gunicsba/AgIsoAuxInputs/hardware/enclosures/handgrip/README.md

# Handgrip housing

A 3D-printed handheld grip for the [Handgrip keypad](../../boards/handgrip/). The layout is inspired by the HARDI NOVA sprayer grip; this project is not affiliated with HARDI.

Printed Handgrip housing with the keypad fitted

| File | Use |
|---|---|
| `handgrip_enclosure.3mf` | Ready to slice and print |
| `handgrip_enclosure.f3z` | Fusion 360 source archive |
