gunicsba/AgIsoAuxInputs/hardware/boards/handgrip/PCB_handgrip_2026-09-13.pdf

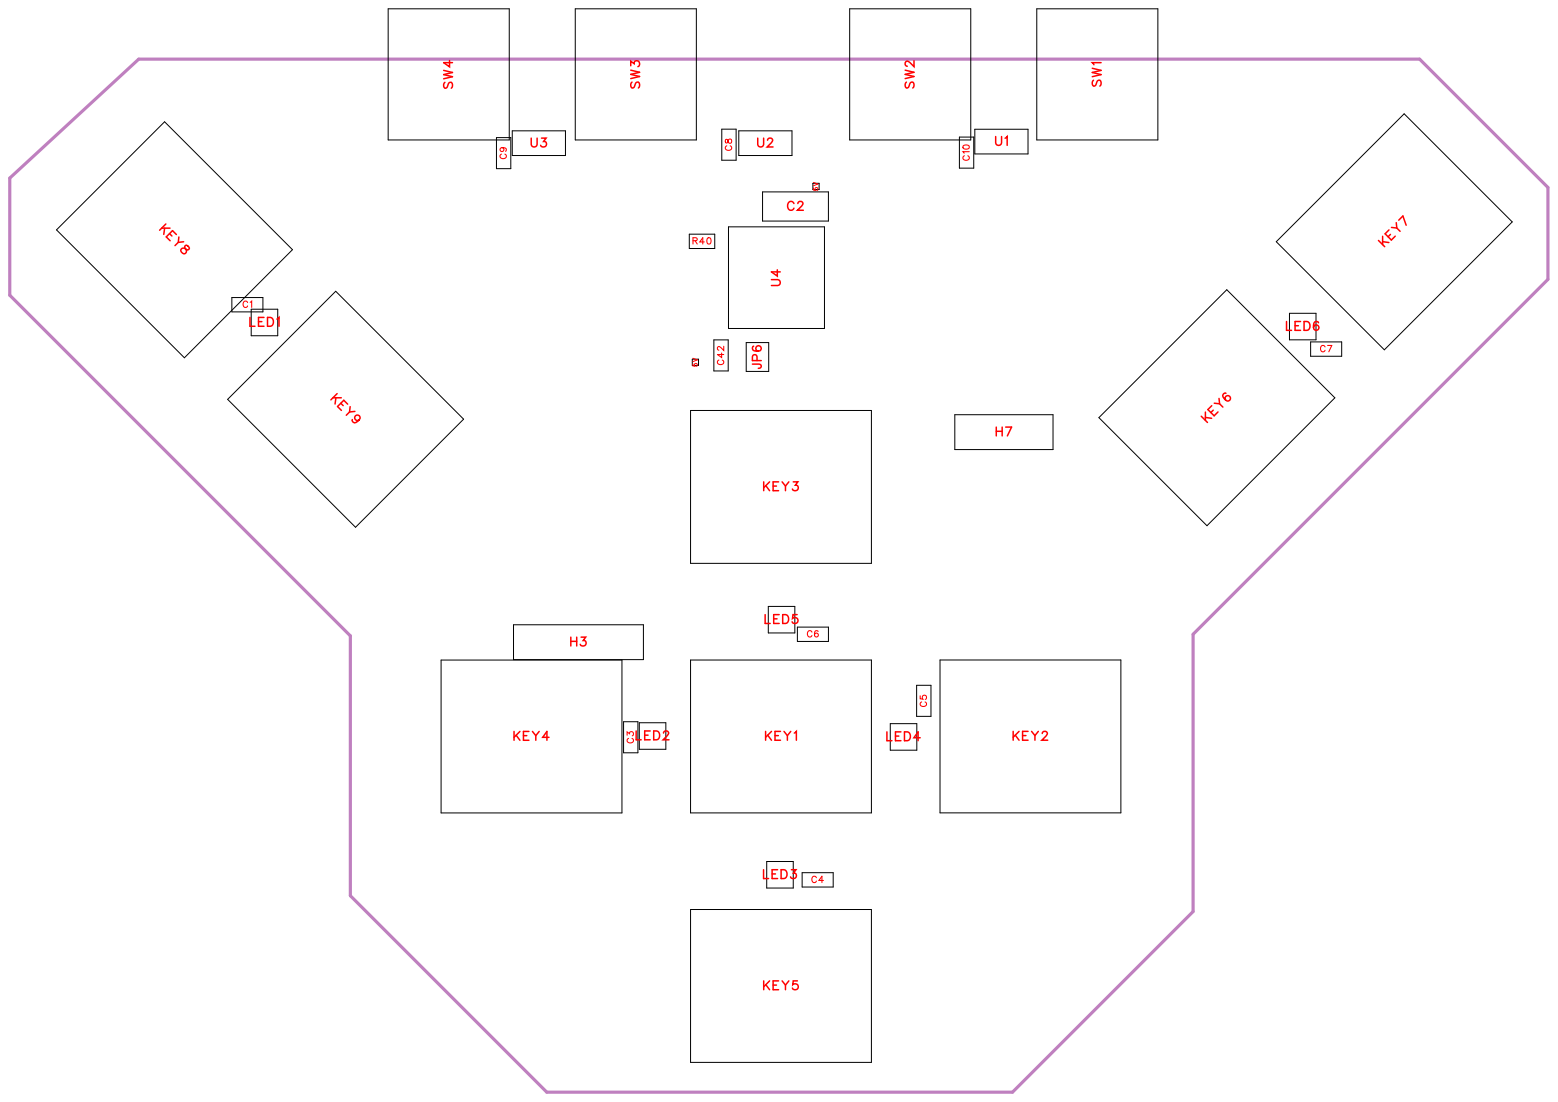
[picture p5: page 1]

H2

H1

No. | Quantity | Comment | Designator | Footprint | Value | Manufacturer Part | Manufacturer | Supplier Part | Supplier | Device | Name
1 | 2 | Test-Point | 5V,5V | Test-Point-0. 5mm | | | | | | Test-Point
2 | 10 | 100nF | C1,C3,C4,C5,C6,C7,C8,C9, C10,C42 | C0402 | 100nF | CL05B104K O5NNNC | SAMSUNG( ) 三星 | C1525 | LCSC | CL05B104K O5NNNC | 100nF
3 | 1 | 100uF | C2 | C1206 | 100uF | CL31A107M QHNNNE | SAMSUNG( 三星 ) | C15008 | LCSC | CL31A107M QHNNNE | 100uF
4 | 9 | B3F-4055 | KEY1,KEY2,KEY3,KEY4,K EY5,KEY6,KEY7,KEY8,KE Y9 | KEY-TH_4P-L12.0-W12.0-P5.00-LS13. 4-EH | | B3F-4055 | OMRON( 欧 姆龙 ) | C84931 | LCSC | B3F-4055_C 84931 | B3F-4055
5 | 6 | SK6805-EC1 5 | LED1,LED2,LED3,LED4,LE D5,LED6 | LED-SMD_4 P-L1.5-W1.5-BL | | SK6805-EC1 5 | OPSCO(欧思 科) | C2890035 | LCSC | SK6805-EC1 5 | SK6805-EC1 5
6 | 1 | 10k | R40 | R0402 | 10k | 0402WGF10 02TCE | UNI-ROYAL( 厚声 ) | C25744 | LCSC | 0402WGF10 02TCE | 10k
7 | 4 | B3F-3152 | SW1,SW2,SW3,SW4 | KEY-TH_4P-L7.3-W10.2-P4.50-LS7.0 | | B3F-3152 | OMRON( 欧 姆龙 ) | C231320 | LCSC | B3F-3152 | B3F-3152
8 | 3 | SK6805SIDE -G-003 | U1,U2,U3 | LED-SMD_4 P-L3.5-W1.6 _SK6805SID E-G-001 | | SK6805SIDE -G-003 | OPSCO(欧思 科) | C31452139 | LCSC | SK6805SIDE -G-003 | SK6805SIDE -G-003
9 | 1 | PCA9555AP W,118 | U4 | TSSOP-24_L 7.8-W4.4-P0. 65-LS6.4-BL | | PCA9555AP W,118 | NXP(恩智浦 ) | C2652295 | LCSC | PCA9555AP W,118 | PCA9555AP W,118

Description | Resistance -Post Trip (R1) (Max) | Resistance -Initial (Ri) (Min)

Test Point 测试点
Capacitance: Tolerance:±10% Tolerance:±10% Voltage Rated: Temperature Coefficient:

Capacitance:100uF Tolerance:±20% Tolerance:±20% Voltage Rating:6.3V Temperature Coefficient:X5R

Circuit:SPST Actuator Style:Rectangular Button Mounting Type:Through Hole Length:12mm Width:12mm Switch Height:7.3mm Contact Current:50mA Voltage Rating:24V With Lamp:- Life:-

Dominant Wavelength - R:620nm~625nm Dominant Wavelength - R:620nm~625nm Dominant Wavelength - G:520nm~530nm Dominant Wavelength - G:520nm~530nm Dominant Wavelength - B:460nm~470nm Dominant Wavelength - B:460nm~470nm Data Transmission Rate:800Kbit/s Voltag

Resistance:10000 Tolerance:±1% Tolerance:±1% Power\(Watts\): Overload Voltage (Max): Temperature Coefficient:±100ppm/ Temperature Coefficient:±100ppm/ Type:Thick Film Resistors Operating Temperature Range:-55 ~+155 Operating Temperature Range:-55 ~+155

Circuit:SPST Actuator Style:Rectangle button Operating Force:150gf Mounting Style:Horizontal Plug Switch Height:3.9mm Contact Current:50mA Voltage Rating (DC):24V With Lamp:- Pin Style:PCPin Mechanical Life:- Operating Temperature:-25 ~+70 Operating Temp

Dominant Wavelength - G:520nm~530nm Dominant Wavelength - G:520nm~530nm Data Transmission Rate:800Kbit/s Voltage - Supply:3.7V~5.5V Voltage -Supply:3.7V~5.5V Quiescent Current:0.25mA Lens Color:Translucent Frosted Lens ESD Withstand Voltage:2000V Operati

Interface:I2C；SMBus Interrupt Output:有中断输出 Output Type: Supply Voltage:1.65V~5.5V Supply Voltage:1.65V~5.5V Output Source current:10mA Output Sink Current:25mA Clock Frequency:400kHz Operating Temperature:-40 ~+85 Operating Temperature:-40 ~+85

1

9

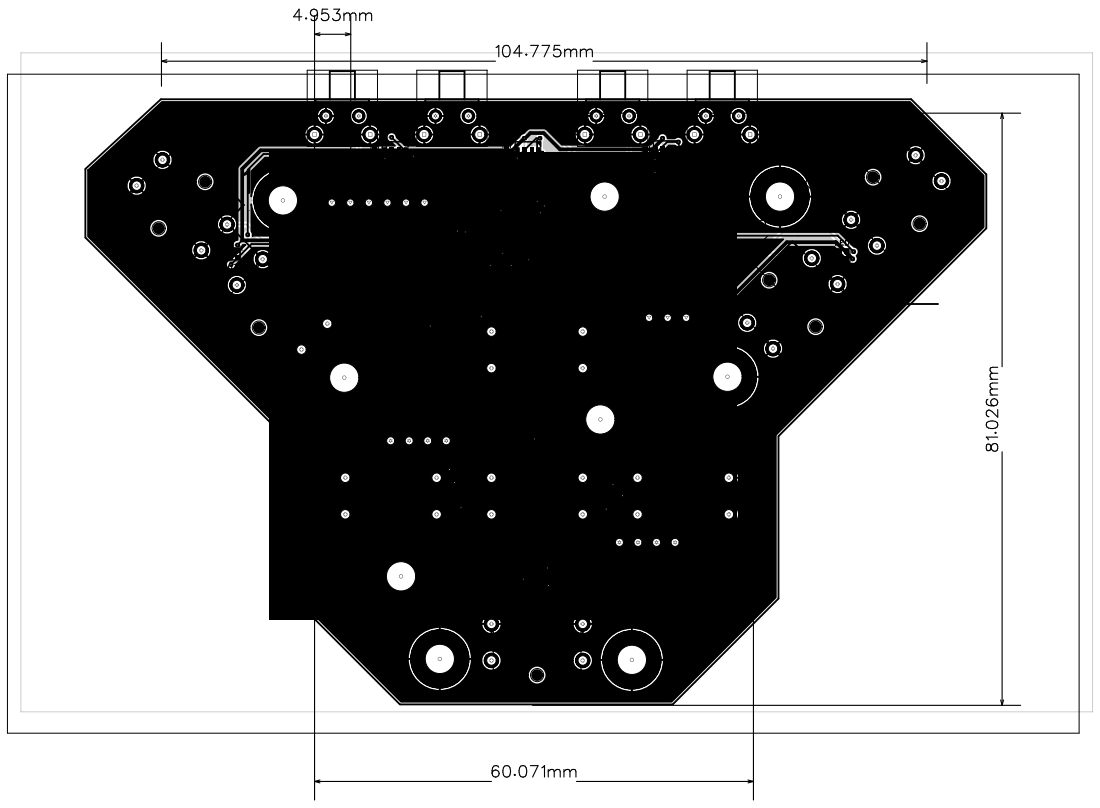
[picture p6: page 5]

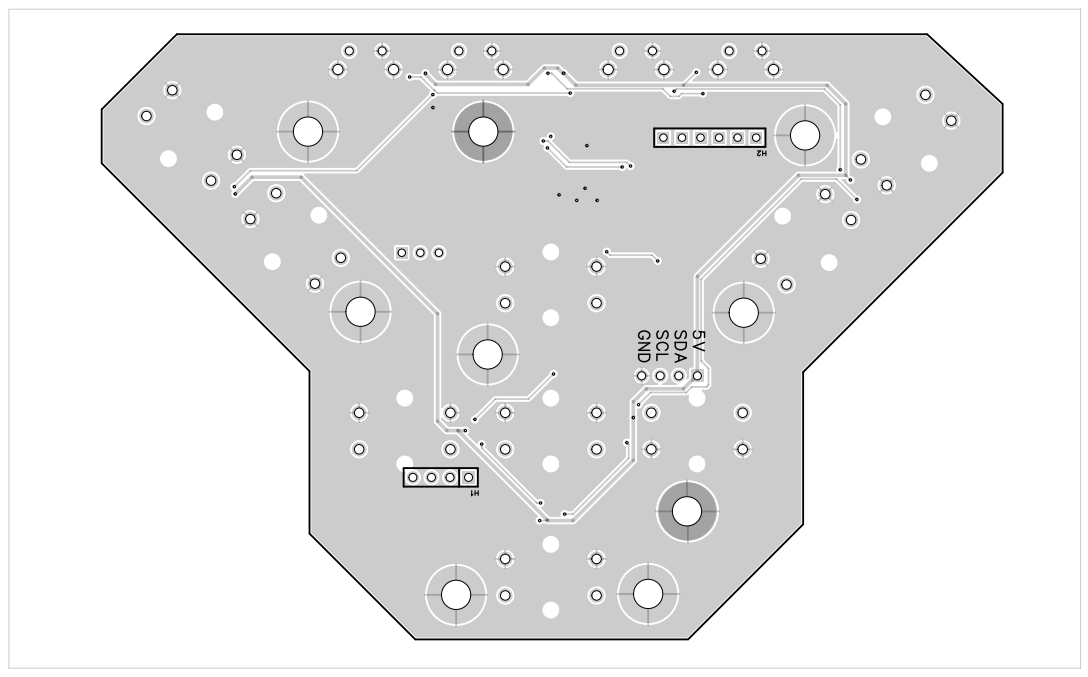
[picture p7: page 6]

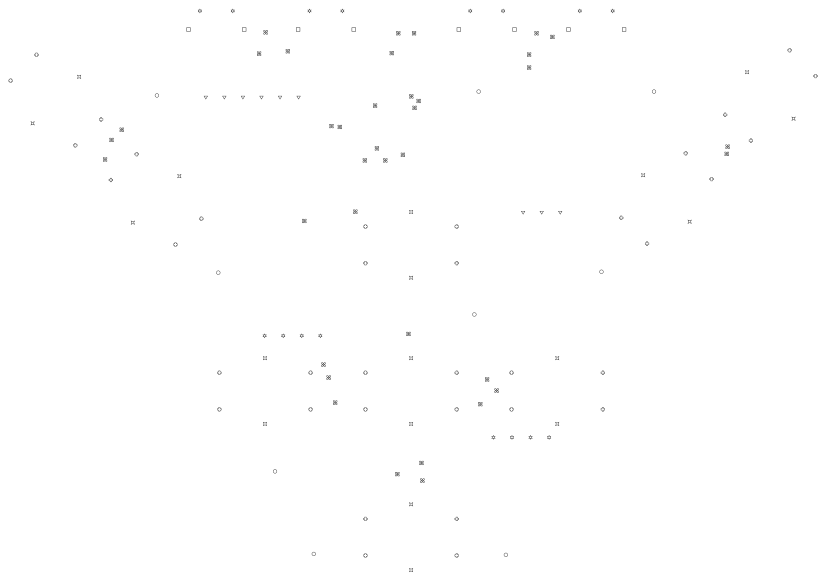
[picture p8: page 7]
