gunicsba/AgIsoAuxInputs/hardware/boards/brain/BOM_brain.xlsx

No. | Quantity | Comment | Designator | Footprint | Value | Manufacturer Part | Manufacturer | Supplier Part | Supplier | Device | Name | Description | Resistance - Post Trip (R1) (Max) | Resistance - Initial (Ri) (Min)
1 | 2 | 100nF | C1,C42 | C0402 | 100nF | CL05B104KO5NNNC | SAMSUNG(三星) | C1525 | LCSC | CL05B104KO5NNNC | 100nF | Capacitance: Tolerance:±10% Tolerance:±10% Voltage Rated: Temperature Coefficient:
2 | 4 | 100uF | C2,C59,C60,C61 | C1206 | 100uF | CL31A107MQHNNNE | SAMSUNG(三星) | C15008 | LCSC | CL31A107MQHNNNE | 100uF | Capacitance:100uF Tolerance:±20% Tolerance:±20% Voltage Rating:6.3V Temperature Coefficient:X5R
3 | 5 | 100nF | C19,C20,C21,C22,C23 | R0402 | 100nF | GRM155R71H104KE14D | muRata(村田) | C77020 | LCSC | GRM155R71H104KE14D | 100nF | 容值:100nF;精度:±10%;额定电压:50V;材质(温度系数):X7R;
4 | 2 | 1uF | C25,C50 | R0402 | 1uF | CL05A105KP5NNNC | SAMSUNG(三星) | C14445 | LCSC | CL05A105KP5NNNC | 1uF | 容值:1uF;精度:±10%;额定电压:10V;材质(温度系数):X5R;
5 | 2 | 10pF | C33,C34 | R0402 | 10pF | CL05C100JB5NNNC | SAMSUNG(三星) | C32949 | LCSC | CL05C100JB5NNNC | 10pF | 容值:10pF;精度:±5%;额定电压:50V;材质(温度系数):C0G;
6 | 5 | 10uF | C40,C46,C47,C53,C57 | C1206 | 10uF | CL31A106KBHNNNE | SAMSUNG(三星) | C13585 | LCSC | CL31A106KBHNNNE | 10uF | Capacitance:10uF Tolerance:±10% Tolerance:±10% Voltage Rating:50V Temperature Coefficient:X5R
7 | 1 | 10nF | C41 | C0402 | 10nF | CGA2B2X7R1E103KT0Y0F | TDK | C76702 | LCSC | CGA2B2X7R1E103KT0Y0F | 10nF | Capacitance: Tolerance:±10% Tolerance:±10% Voltage Rated: Temperature Coefficient:
8 | 4 | 100nF | C51,C52,C55,C58 | C0603 | 100nF | CC0603KRX7R9BB104 | YAGEO(国巨) | C14663 | LCSC | CC0603KRX7R9BB104 | 100nF | Capacitance:100nF Tolerance:±10% Tolerance:±10% Voltage Rating:50V Temperature Coefficient:X7R
9 | 1 | 8.2pF | C54 | r0402 | 8.2pF | 0402CG8R2C500NT | FH(风华) | C1579 | LCSC | 0402CG8R2C500NT | 8.2pF | 容值:8.2pF;额定电压:50V;材质(温度系数):C0G;
10 | 1 | PESD1CAN,215 | D5 | SOT-23_L2.9-W1.3-P1.90-LS2.4-BR |  | PESD1CAN,215 | Nexperia(安世) | C15771 | LCSC | PESD1CAN,215 | PESD1CAN,215 | Polarity:Bi-Directional Reverse Stand-Off Voltage (Vrwm):24V Breakdown Voltage (VBR):25.4V Peak Pulse Current(Ipp)@8/20us:3A Clamping Voltage@Ipp:70V Peak Pulse Power(Ppp)@8/20us:200W Junction Capacitance(Cj)@1MHz:11pF@1MHz Operating Temperature:-65℃~+150
11 | 1 | SS54 | D6 | SMA_L4.4-W2.8-LS5.4-R-RD |  | SS54 | MDD(辰达半导体) | C22452 | LCSC | SS54_C22452 | SS54 | Diode Configuration:Independent Voltage - Forward(Vf@If):550mV@5A Voltage - DC Reverse(Vr):40V Current - Rectified:5A Reverse Leakage Current (Ir):1mA@40V Operating Junction Temperature Range:-55℃~+125℃ Operating Junction Temperature Range:-55℃~+125℃
12 | 2 | 1N5819WS | D7,D8 | SOD-323_L1.8-W1.3-LS2.5-RD |  | 1N5819WS | Hottech(合科泰) | C191023 | LCSC | 1N5819WS_C191023 | 1N5819WS | Voltage - Forward(Vf@If):600mV@1A Voltage - DC Reverse(Vr):40V Current - Rectified:1A Non-Repetitive Peak Forward Surge Current:25A
13 | 4 | BAV99 | D12,D13,D14,D15 | SOT-23_L2.9-W1.3-P1.90-LS2.4-BR |  | BAV99 | BLUEROCKET(蓝箭) | C305472 | LCSC | BAV99_C305472 | BAV99
14 | 1 | PZ2.54-1x3PZZ-L11.5 | H1 | HDR-TH_PZ2.54-1X3PZZ-L11.5 |  | PZ2.54-1x3PZZ-L11.5 | SHOU HAN(首韩) | C54876668 | LCSC | PZ2.54-1x3PZZ-L11.5 | PZ2.54-1x3PZZ-L11.5 | Pin Structure:1x3P Pitch:2.54mm Row Spacing:2.54mm Circluar Pins/Square Pins:Pin Header Mounting Type:Through Hole Number of Rows:1 Number of Pins:3P Current Rating:3A Voltage Rating (Max):250V Length of Mating Pin:6mm Insulation Height:2.5mm Length of En
15 | 3 | PZ2.54-1x6PZZ-L11.5 | H4,H5,H6 | HDR-TH_PZ2.54-1X6PZZ-L11.5 |  | PZ2.54-1x6PZZ-L11.5 | SHOU HAN(首韩) | C54876671 | LCSC | PZ2.54-1x6PZZ-L11.5 | PZ2.54-1x6PZZ-L11.5 | Pin Structure:1x6P Pitch:2.54mm Row Spacing:2.54mm Circluar Pins/Square Pins:Pin Header Mounting Type:Through Hole Number of Rows:1 Number of Pins:6P Current Rating:3A Voltage Rating (Max):250V Length of Mating Pin:6mm Insulation Height:2.5mm Length of En
16 | 1 | 2nH | L4 | R0402 | 2nH | MLG1005S2N0BT000 | TDK | C76769 | LCSC | MLG1005S2N0BT000 | 2nH | 电感值:2nH;精度:-;额定电流:900mA;饱和电流(Isat):-;直流电阻(DCR):70mΩ;
17 | 1 | 39nH | L6 | r0402 | 39nH | SDCL1005C39NJTDF | Sunlord(顺络) | C26443 | LCSC | SDCL1005C39NJTDF | 39nH | 电感值:39nH;额定电流:200mA;直流电阻(DCR):1Ω;精度:±5%;
18 | 1 | 1.3nH | L7 | r0402 | 1.3nH | SDCL1005C1N3STDF | Sunlord(顺络) | C279756 | LCSC | SDCL1005C1N3STDF | 1.3nH | 电感值:1.3nH;精度:-;额定电流:400mA;直流电阻(DCR):100mΩ;饱和电流(Isat):-;
19 | 1 | 24nH | L8 | r0402 | 24nH | SDCL1005C24NJTDF | Sunlord(顺络) | C74301 | LCSC | SDCL1005C24NJTDF | 24nH | 电感值:24nH;精度:±5%;额定电流:-;饱和电流(Isat):-;直流电阻(DCR):-;
20 | 1 | 15uH | L9 | IND-SMD_L7.0-W6.6_FXL0630 | 15uH | FXL0630-150-M | cjiang(长江微电) | C177243 | LCSC | FXL0630-150-M | 15uH | Inductance:15uH Tolerance:±20% Tolerance:±20% Current Rating:3A Current - Saturation(Isat):4A DC Resistance(DCR):115mΩ Type:Molded Inductor Ratings:-
21 | 4 | KT-0805G | LED5,LED6,LED7,LED8 | LED0805-R-RD |  | KT-0805G | KENTO | C2297 | LCSC | KT-0805G | KT-0805G | Lamp Holder Type:- Illumination Color:Emerald Green Voltage - Forward(Vf):2.6V~3.1V Voltage - Forward(Vf):2.6V~3.1V Power(Watts):100mW Forward Current:5mA Wavelength - Dominant:513nm~528nm Wavelength - Dominant:513nm~528nm Peak Wavelength:525nm Diode Conf
22 | 1 | AON7544 | Q1 | DFN-8_L3.2-W3.1-P0.65-LS3.4-BL |  | AON7544 | HXY MOSFET(华轩阳电子) | C5261066 | LCSC | AON7544_C5261066 | AON7544 | Number:1 N-Channel Drain to Source Voltage:30V Current - Continuous Drain(Id):100A RDS(on):5.5mΩ@10V,30A Pd - Power Dissipation:62.5W Gate Threshold Voltage (Vgs(th)):2.5V Gate Charge(Qg):31.6nC@4.5V Input Capacitance(Ciss):3.075nF@15V Reverse Transfer Ca
23 | 6 | 220Ω | R1,R4,R5,R6,R7,R32 | R0402 | 220Ω | 0402WGF2200TCE | UNI-ROYAL(厚声) | C25091 | LCSC | 0402WGF2200TCE | 220Ω | Type:Thick Film Resistor Resistance:220Ω Tolerance:±1% Tolerance:±1% Power(Watts):62.5mW Voltage-Supply(Max):50V Temperature Coefficient:±100ppm/℃ Temperature Coefficient:±100ppm/℃ Operating Temperature:-55℃~+155℃ Operating Temperature:-55℃~+155℃
24 | 2 | 10kΩ | R2,R3 | R0603 | 10kΩ | 0603WAF1002T5E | UNI-ROYAL(厚声) | C25804 | LCSC | 0603WAF1002T5E | 10kΩ | Type:Thick Film Resistors Resistance: Tolerance:±1% Tolerance:±1% Power(Watts): Temperature Coefficient:±100ppm/℃ Temperature Coefficient:±100ppm/℃ Overload Voltage (Max): Operating Temperature Range:-55℃~+155℃ Operating Temperature Range:-55℃~+155℃
25 | 4 | 4.7kΩ | R13,R14,R15,R27 | R0402 | 4.7kΩ | 0402WGF4701TCE | UNI-ROYAL(厚声) | C25900 | LCSC | 0402WGF4701TCE | 4.7kΩ | Type:Thick Film Resistor Resistance:4.7kΩ Tolerance:±1% Tolerance:±1% Power(Watts):62.5mW Voltage-Supply(Max):50V Temperature Coefficient:±100ppm/℃ Temperature Coefficient:±100ppm/℃ Operating Temperature:-55℃~+155℃ Operating Temperature:-55℃~+155℃
26 | 2 | 5.1kΩ | R18,R19 | R0402 | 5.1kΩ | 0402WGF5101TCE | UNI-ROYAL(厚声) | C25905 | LCSC | 0402WGF5101TCE | 5.1kΩ | 电阻类型:厚膜电阻;阻值:5.1kΩ;精度:±1%;功率:62.5mW;
27 | 3 | 15kΩ | R26,R29,R31 | R0402 | 15kΩ | 0402WGF1502TCE | UNI-ROYAL(厚声) | C25756 | LCSC | 0402WGF1502TCE | 15kΩ | 电阻类型:厚膜电阻;阻值:15kΩ;精度:±1%;功率:62.5mW;
28 | 1 | 1.5kΩ | R28 | R0402 | 1.5kΩ | 0402WGF1501TCE | UNI-ROYAL(厚声) | C25867 | LCSC | 0402WGF1501TCE | 1.5kΩ | Type:Thick Film Resistors Resistance:1.5kΩ Tolerance:±1% Tolerance:±1% Power(Watts): Overload Voltage (Max): Temperature Coefficient:±100ppm/℃ Temperature Coefficient:±100ppm/℃ Operating Temperature Range:-55℃~+155℃ Operating Temperature Range:-55℃~+155℃
29 | 2 | 10kΩ | R40,R41 | R0402 | 10kΩ | 0402WGF1002TCE | UNI-ROYAL(厚声) | C25744 | LCSC | 0402WGF1002TCE | 10kΩ | Resistance:10000Ω Tolerance:±1% Tolerance:±1% Power(Watts): Overload Voltage (Max): Temperature Coefficient:±100ppm/℃ Temperature Coefficient:±100ppm/℃ Type:Thick Film Resistors Operating Temperature Range:-55℃~+155℃ Operating Temperature Range:-55℃~+155℃
30 | 4 | 1.2kΩ | R163,R165,R166,R170 | R0603 | 1.2kΩ | 0603WAF1201T5E | UNI-ROYAL(厚声) | C22765 | LCSC | 0603WAF1201T5E | 1.2kΩ | Resistance:1200Ω Tolerance:±1% Tolerance:±1% Power(Watts): Overload Voltage (Max): Temperature Coefficient:±100ppm/℃ Temperature Coefficient:±100ppm/℃ Type:Thick Film Resistors Operating Temperature Range:-55℃~+155℃ Operating Temperature Range:-55℃~+155℃
31 | 2 | TS-1088-AR02016 | SW1,SW2 | SW-SMD_L3.9-W3.0-P4.45 |  | TS-1088-AR02016 | XUNPU(讯普) | C720477 | LCSC | TS-1088-AR02016 | TS-1088-AR02016 | Circuit:SPST Actuator Style:Round Button Operating Force:1.6N Mounting Type:Surface Mount,Vertical Length:4mm Width:3mm Switch Height:2mm with Bracket:Without Bracket Contact Current:50mA Voltage Rating:12V Actuator/Cap Color:Black Termination Style:SMD(S
32 | 1 | ADS1115IDGSR | U1 | MSOP-10_L3.0-W3.0-P0.50-LS5.0-BL |  | ADS1115IDGSR | TI(德州仪器) | C37593 | LCSC | ADS1115IDGSR | ADS1115IDGSR
33 | 1 | USB-TYPE-C-019 | U2 | TYPE-C-SMD_HX-TYPE-C-16PIN |  | USB-TYPE-C-019 | DEALON(德艺隆) | C2927039 | LCSC | USB-TYPE-C-019 | USB-TYPE-C-019
34 | 1 | ESP32-S3(R8) | U3 | QFN-56_L7.0-W7.0-P0.40-TL-EP4.0 |  | ESP32-S3(R8) | ESPRESSIF(乐鑫) | C2913194 | LCSC | ESP32-S3(R8) | ESP32-S3(R8) | 应用领域:蓝牙,WiFi;频率范围:2.412GHz~2.484GHz;数据速率:150Mbps;灵敏度:-98.4dBm;接口:I2C,I2S,SPI,UART,USB;
35 | 1 | PCA9555APW,118 | U4 | TSSOP-24_L7.8-W4.4-P0.65-LS6.4-BL |  | PCA9555APW,118 | NXP(恩智浦) | C2652295 | LCSC | PCA9555APW,118 | PCA9555APW,118 | Interface:I2C；SMBus Interrupt Output:有中断输出 Output Type: Supply Voltage:1.65V~5.5V Supply Voltage:1.65V~5.5V Output Source current:10mA Output Sink Current:25mA Clock Frequency:400kHz Operating Temperature:-40℃~+85℃ Operating Temperature:-40℃~+85℃
36 | 1 | BY25Q64ASSIG(T) | U5 | SOIC-8_L5.3-W5.3-P1.27-LS8.0-BL |  | BY25Q64ASSIG(T) | BOYAMICRO(博雅) | C484306 | LCSC | BY25Q64ASSIG(T) | BY25Q64ASSIG(T)
37 | 1 | MCP2562-E/SN | U14 | SOIC-8_L5.0-W4.0-P1.27-LS6.0-BL |  | MCP2562-E/SN | MICROCHIP(美国微芯) | C53609 | LCSC | MCP2562-E/SN | MCP2562-E/SN | Type:Transceiver Supply Voltage:4.5V~5.5V Supply Voltage:4.5V~5.5V
38 | 1 | PCA9306DCUR | U22 | SSOP-8_L2.0-W2.3-P0.50-LS3.1-BR |  | PCA9306DCUR | TI(德州仪器) | C33196 | LCSC | PCA9306DCUR | PCA9306DCUR | Channel Type:Bi-Directional Number of Channels:2 Supply Voltage (VCCA):1.2V~3.3V Supply Voltage (VCCA):1.2V~3.3V Supply Voltage (VCCB):1.8V~5.5V Supply Voltage (VCCB):1.8V~5.5V Input Signal:- Output Signal:- Output Type:Open Drain，Push-pull Data Rate:- Op
39 | 1 | RFANT5220110A0T | U25 | FILTER-SMD_L5.2-W2.0-L |  | RFANT5220110A0T | Walsin(华新科) | C127611 | LCSC | RFANT5220110A0T | RFANT5220110A0T | 2.4 GHz 陶瓷天线
40 | 1 | NCV68061SNAIT1G | U26 | TSOP-6_L3.0-W1.5-P0.95-BL |  | NCV68061SNAIT1G | onsemi(安森美) | C5206748 | LCSC | NCV68061SNAIT1G | NCV68061SNAIT1G
41 | 1 | TPS5430DDAR | U27 | ESOP-8_L4.9-W3.9-P1.27-LS6.0-TL-EP |  | TPS5430DDAR | TI(德州仪器) | C9864 | LCSC | TPS5430DDAR | TPS5430DDAR | Function:Buck Voltage - Supply:5.5V~36V Voltage - Supply:5.5V~36V Output Voltage:1.221V~32.04V Output Voltage:1.221V~32.04V Output Current:3A Frequency - Switching:500kHz Frequency - Switching:500kHz Operating Temperature:-40℃~+125℃@(TJ) Operating Tempera
42 | 1 | EL3H7(B)(TA)-G | U28 | SSOP-4_L4.4-W2.7-P1.27-LS7.0-TL |  | EL3H7(B)(TA)-G | EVERLIGHT(亿光) | C5213653 | LCSC | EL3H7(B)(TA)-G_C5213653 | EL3H7(B)(TA)-G | Input type:DC Output Type:Phototransistor Voltage - Forward(Vf):1.2V Output Current:50mA Isolation Voltage(Vrms):3.75kV Reverse Voltage:6V Load Voltage:80V Vce Saturation(VCE(sat)):200mV@10mA,1mA Rise time:5us Fall time:3us Operating Temperature:-55℃~+110
43 | 1 | AMS1117-3.3 | U29 | SOT-223-3_L6.5-W3.4-P2.30-LS7.0-BR |  | AMS1117-3.3 | AMS | C6186 | LCSC | AMS1117-3.3_C6186 | AMS1117-3.3 | Output Type:Fixed Voltage - Supply:16V Output Voltage:3.3V Output Voltage:3.3V Output Current:1A Power Supply Rejection Ratio (PSRR):72dB@(120Hz) Voltage Dropout:1.1V@(800mA) standby current:5mA Noise:0.003%Vout Features:Over Current Protection；Over Tempe
44 | 1 | 40MHz | X1 | crystal-smd_4p-l2.5-w2.0-bl | 40MHz | S2240000101050JY | JGHC(晶光华) | C2885592 | LCSC | S2240000101050JY | 40MHz | 频率:40MHz;频率公差:±10ppm;负载电容:10pF;
