gunicsba/AgIsoAuxInputs/hardware/boards/handgrip/BOM_handgrip.xlsx

No. | Quantity | Comment | Designator | Footprint | Value | Manufacturer Part | Manufacturer | Supplier Part | Supplier | Device | Name | Description | Resistance - Post Trip (R1) (Max) | Resistance - Initial (Ri) (Min)
1 | 15 | Test-Point | 5V,5V,TP1,TP2,TP3,TP4,TP5,TP6,TP7,TP8,TP9,TP10,TP11,TP12,TP13 | Test-Point-0.5mm |  |  |  |  |  | Test-Point |  | Test Point 测试点
2 | 1 | 100uF | C2 | C1206 | 100uF | CL31A107MQHNNNE | SAMSUNG(三星) | C15008 | LCSC | CL31A107MQHNNNE | 100uF | Capacitance:100uF Tolerance:±20% Tolerance:±20% Voltage Rating:6.3V Temperature Coefficient:X5R
3 | 1 | 100nF | C42 | C0402 | 100nF | CL05B104KO5NNNC | SAMSUNG(三星) | C1525 | LCSC | CL05B104KO5NNNC | 100nF | Capacitance: Tolerance:±10% Tolerance:±10% Voltage Rated: Temperature Coefficient:
4 | 9 | B3F-4055 | KEY1,KEY2,KEY3,KEY4,KEY5,KEY6,KEY7,KEY8,KEY9 | KEY-TH_4P-L12.0-W12.0-P5.00-LS13.4-EH |  | B3F-4055 | OMRON(欧姆龙) | C84931 | LCSC | B3F-4055_C84931 | B3F-4055 | Circuit:SPST Actuator Style:Rectangular Button Mounting Type:Through Hole Length:12mm Width:12mm Switch Height:7.3mm Contact Current:50mA Voltage Rating:24V With Lamp:- Life:-
5 | 2 | 10kΩ | R40,R41 | R0402 | 10kΩ | 0402WGF1002TCE | UNI-ROYAL(厚声) | C25744 | LCSC | 0402WGF1002TCE | 10kΩ | Resistance:10000Ω Tolerance:±1% Tolerance:±1% Power(Watts): Overload Voltage (Max): Temperature Coefficient:±100ppm/℃ Temperature Coefficient:±100ppm/℃ Type:Thick Film Resistors Operating Temperature Range:-55℃~+155℃ Operating Temperature Range:-55℃~+155℃
6 | 4 | B3F-3152 | SW1,SW2,SW3,SW4 | KEY-TH_4P-L7.3-W10.2-P4.50-LS7.0 |  | B3F-3152 | OMRON(欧姆龙) | C231320 | LCSC | B3F-3152 | B3F-3152 | Circuit:SPST Actuator Style:Rectangle button Operating Force:150gf Mounting Style:Horizontal Plug Switch Height:3.9mm Contact Current:50mA Voltage Rating (DC):24V With Lamp:- Pin Style:PCPin Mechanical Life:- Operating Temperature:-25℃~+70℃ Operating Temp
7 | 1 | PCA9555APW,118 | U4 | TSSOP-24_L7.8-W4.4-P0.65-LS6.4-BL |  | PCA9555APW,118 | NXP(恩智浦) | C2652295 | LCSC | PCA9555APW,118 | PCA9555APW,118 | Interface:I2C；SMBus Interrupt Output:有中断输出 Output Type: Supply Voltage:1.65V~5.5V Supply Voltage:1.65V~5.5V Output Source current:10mA Output Sink Current:25mA Clock Frequency:400kHz Operating Temperature:-40℃~+85℃ Operating Temperature:-40℃~+85℃
