gunicsba/AgIsoAuxInputs/hardware/enclosures/handgrip/handgrip_enclosure.3mf

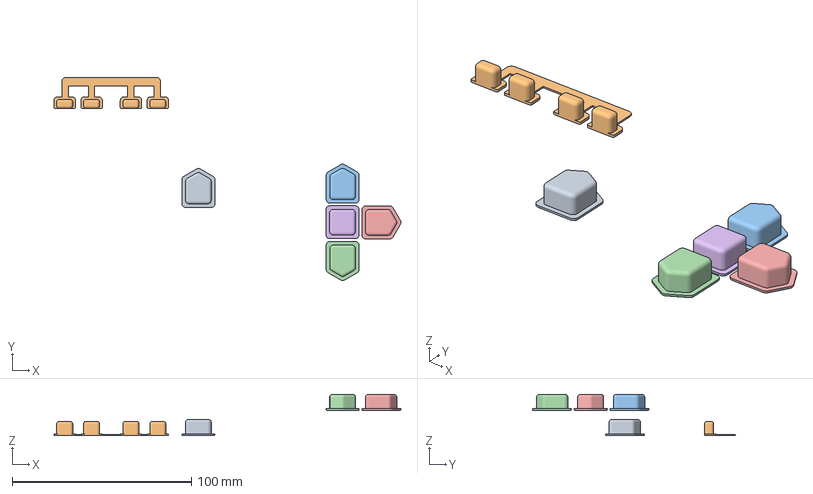
[picture p9: CAD file, 2026-09-13]
hardware/enclosures/handgrip/handgrip_enclosure.3mf
193.8 x 113.5 x 23.0 mm
