gunicsba/AgIsoAuxInputs/hardware/enclosures/jh-d400x/jh-d400x_enclosure.3mf

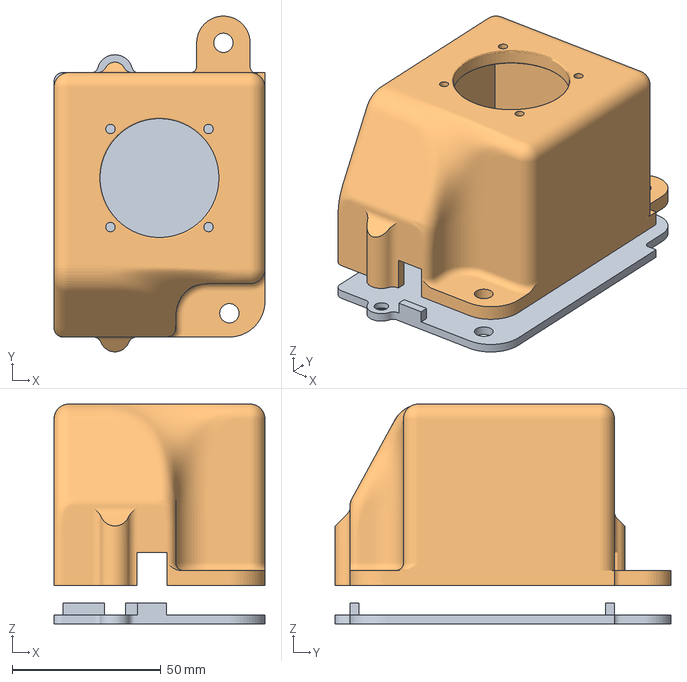
[picture p10: CAD file, 2026-09-13]
hardware/enclosures/jh-d400x/jh-d400x_enclosure.3mf
71.0 x 113.0 x 74.0 mm
Lid
Top
