gunicsba/AgIsoAuxInputs/(list of files, cad)

Other CAD files:
hardware/enclosures/handgrip/handgrip_enclosure.f3z
hardware/enclosures/jh-d400x/jh-d400x_enclosure.f3d
