gunicsba/AgIsoAuxInputs/hardware/schematic.pdf

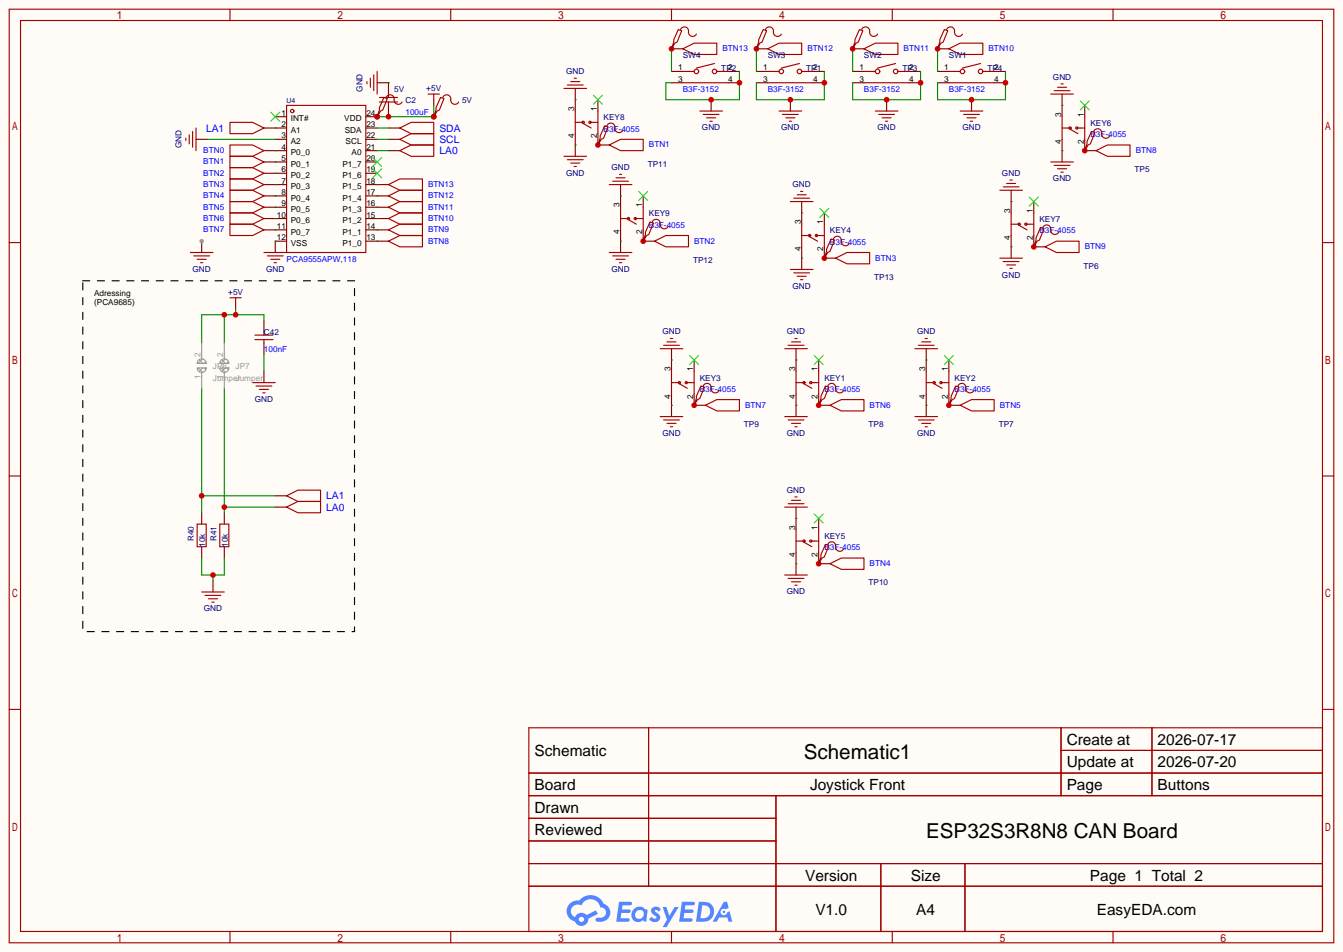
[picture p11: page 1]

Schematic | Schematic1 | Create at | 2026-07-17

Update at | 2026-07-20

Board | Joystick Front | Page | Buttons
Drawn | | ESP32S3R8N8 CAN Board
Reviewed

Version | Size | Page 1 Total 2
V1.0 | A4 | EasyEDA.com

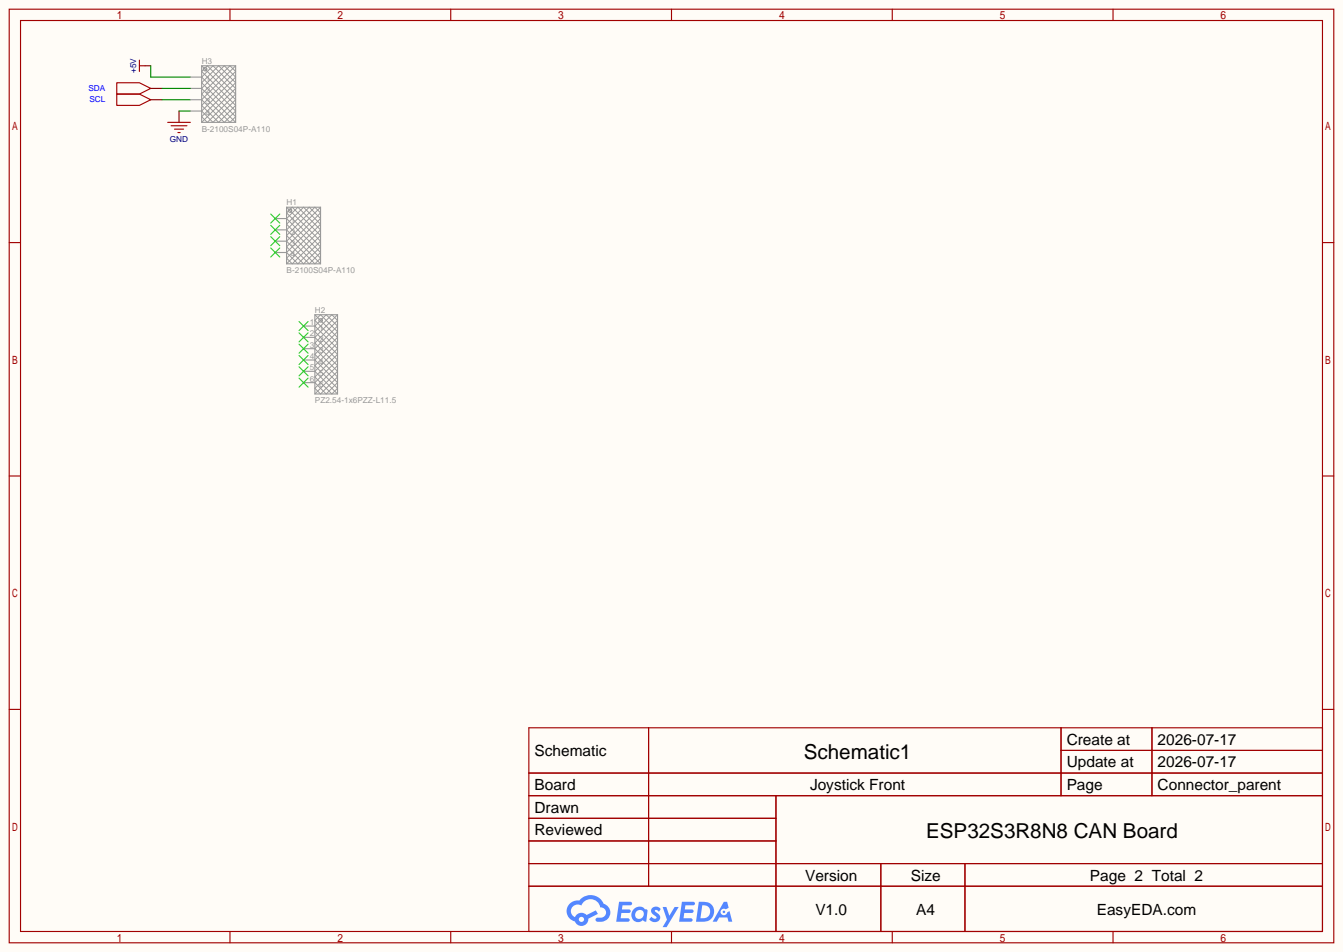
[picture p12: page 2]

Schematic | Schematic1 | Create at | 2026-07-17

Update at | 2026-07-17

Board | Joystick Front | Page | Connector_parent
Drawn | | ESP32S3R8N8 CAN Board
Reviewed

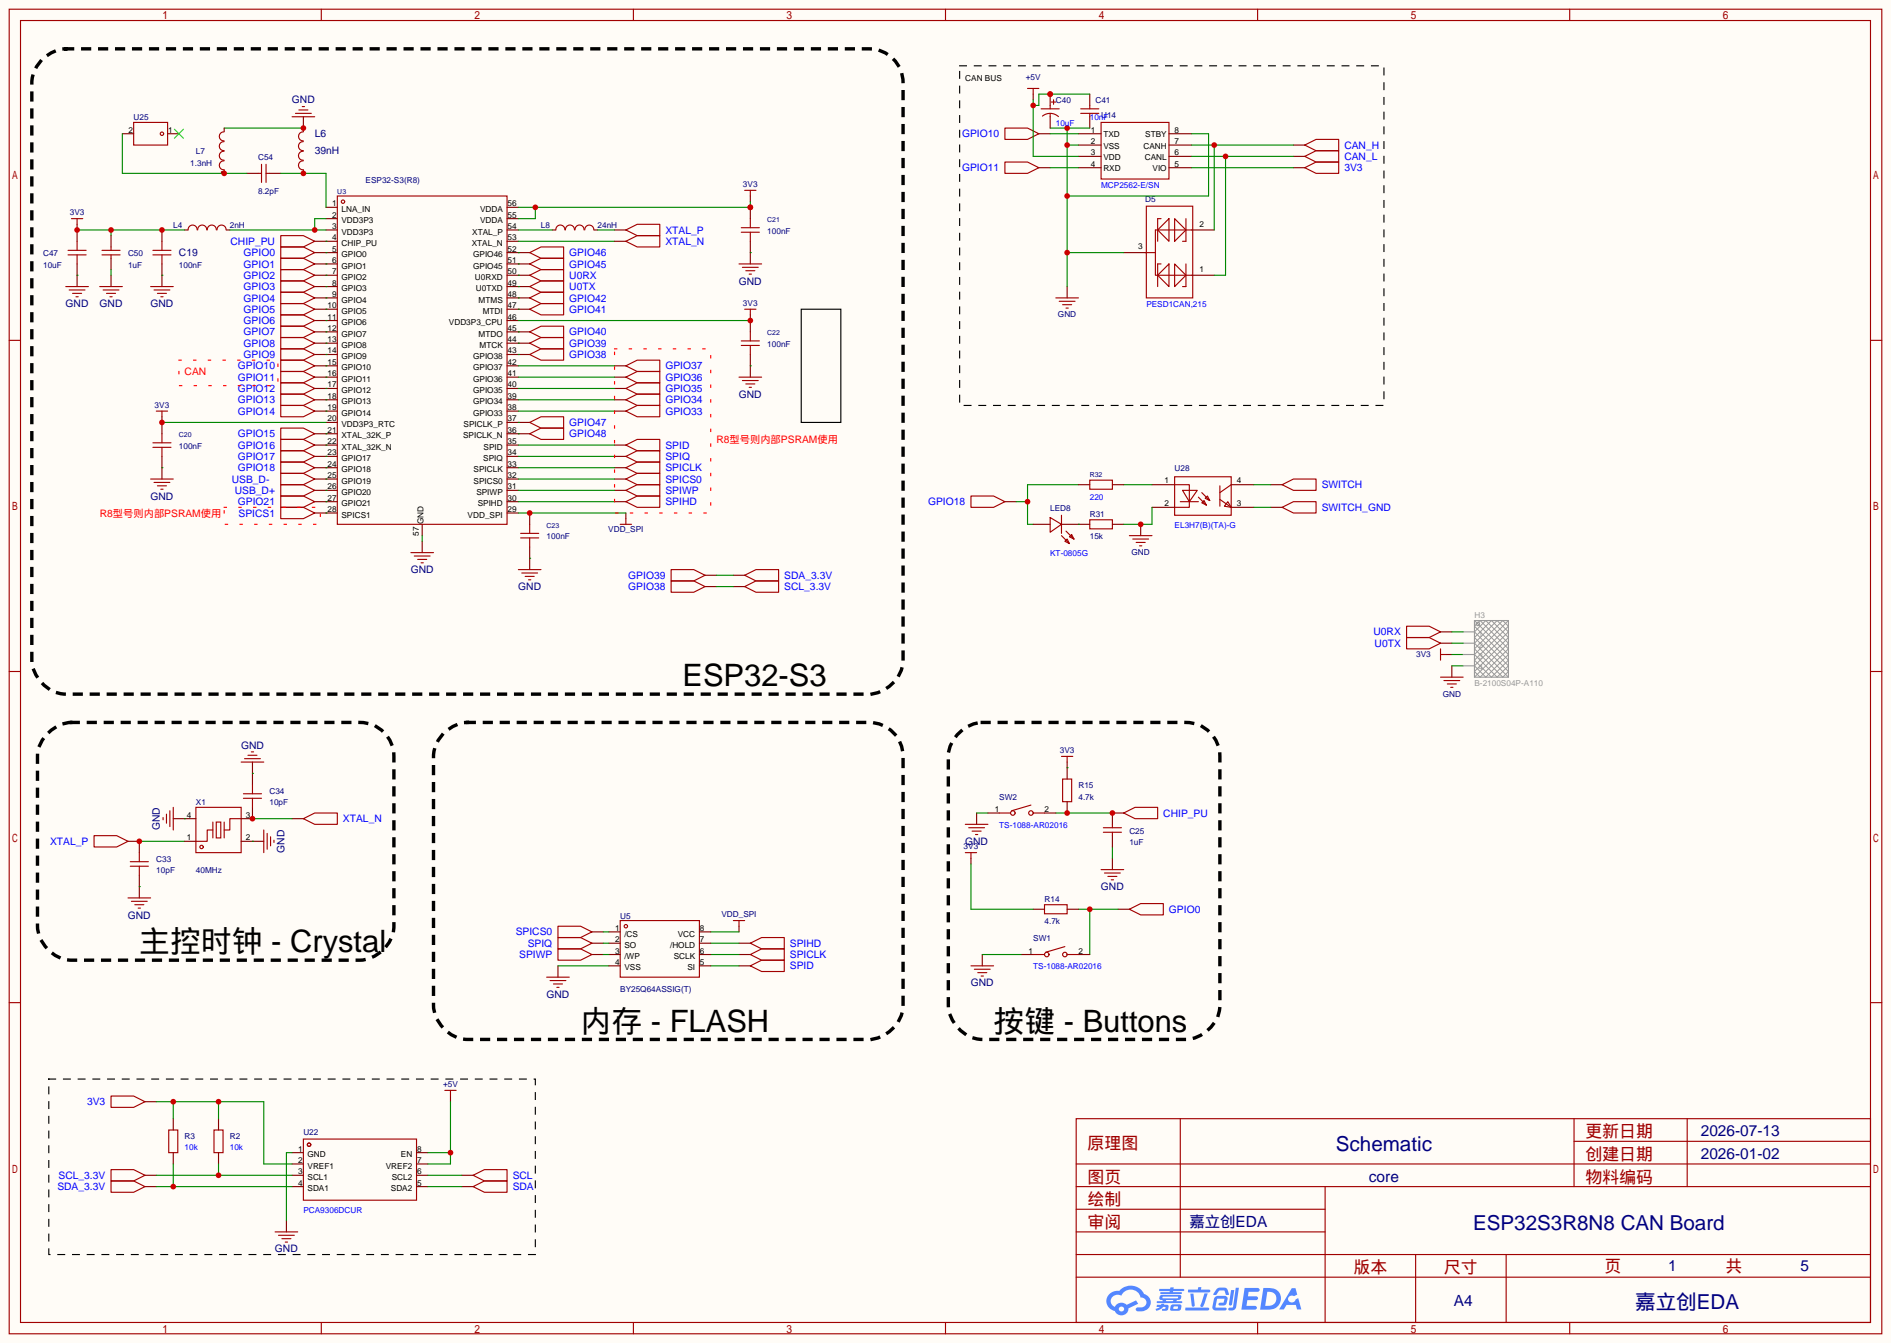
[picture p13: page 3]

# AON7544 NC

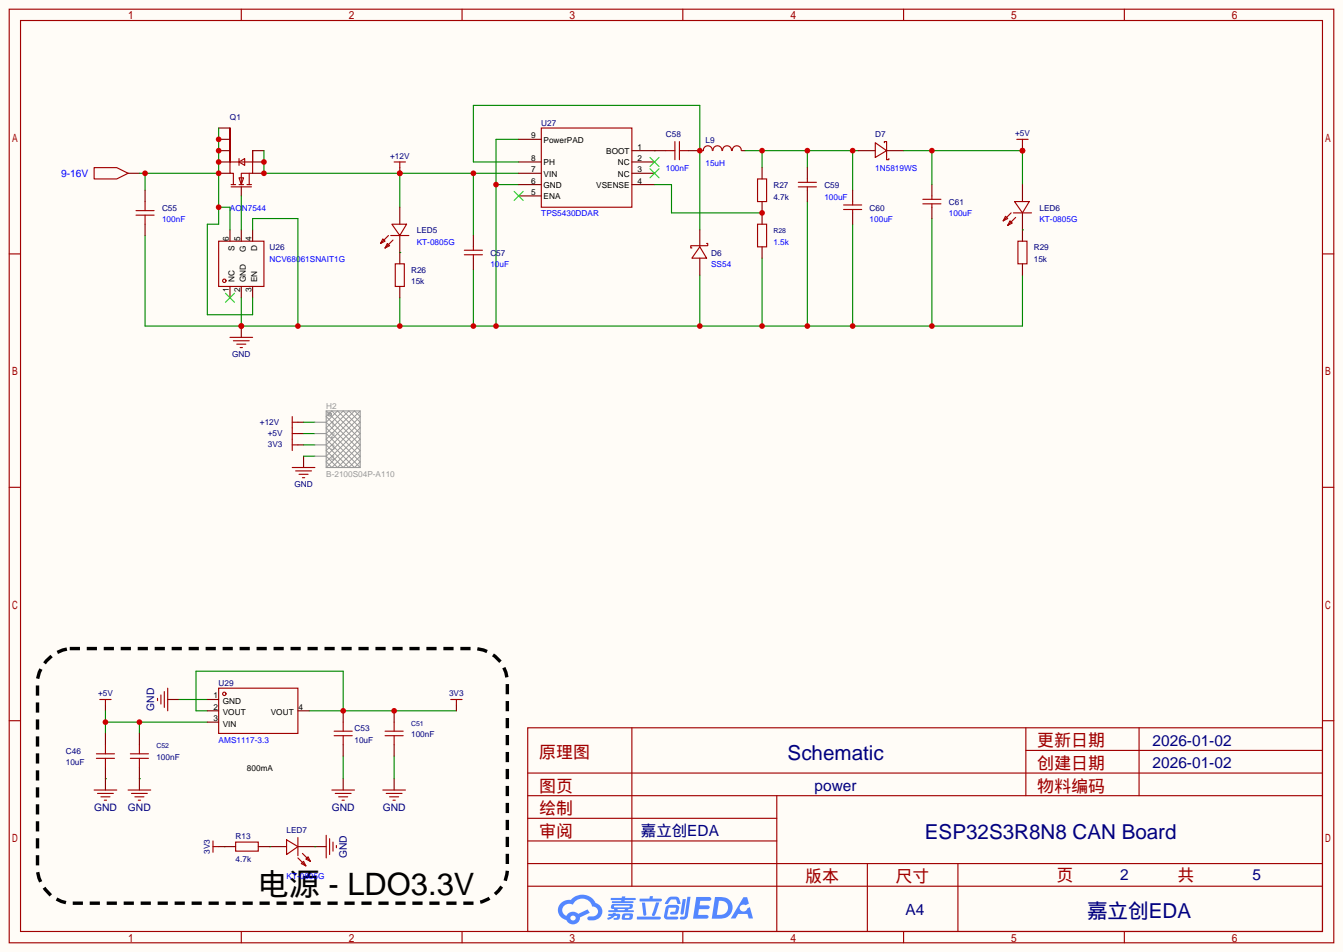
[picture p14: page 4]

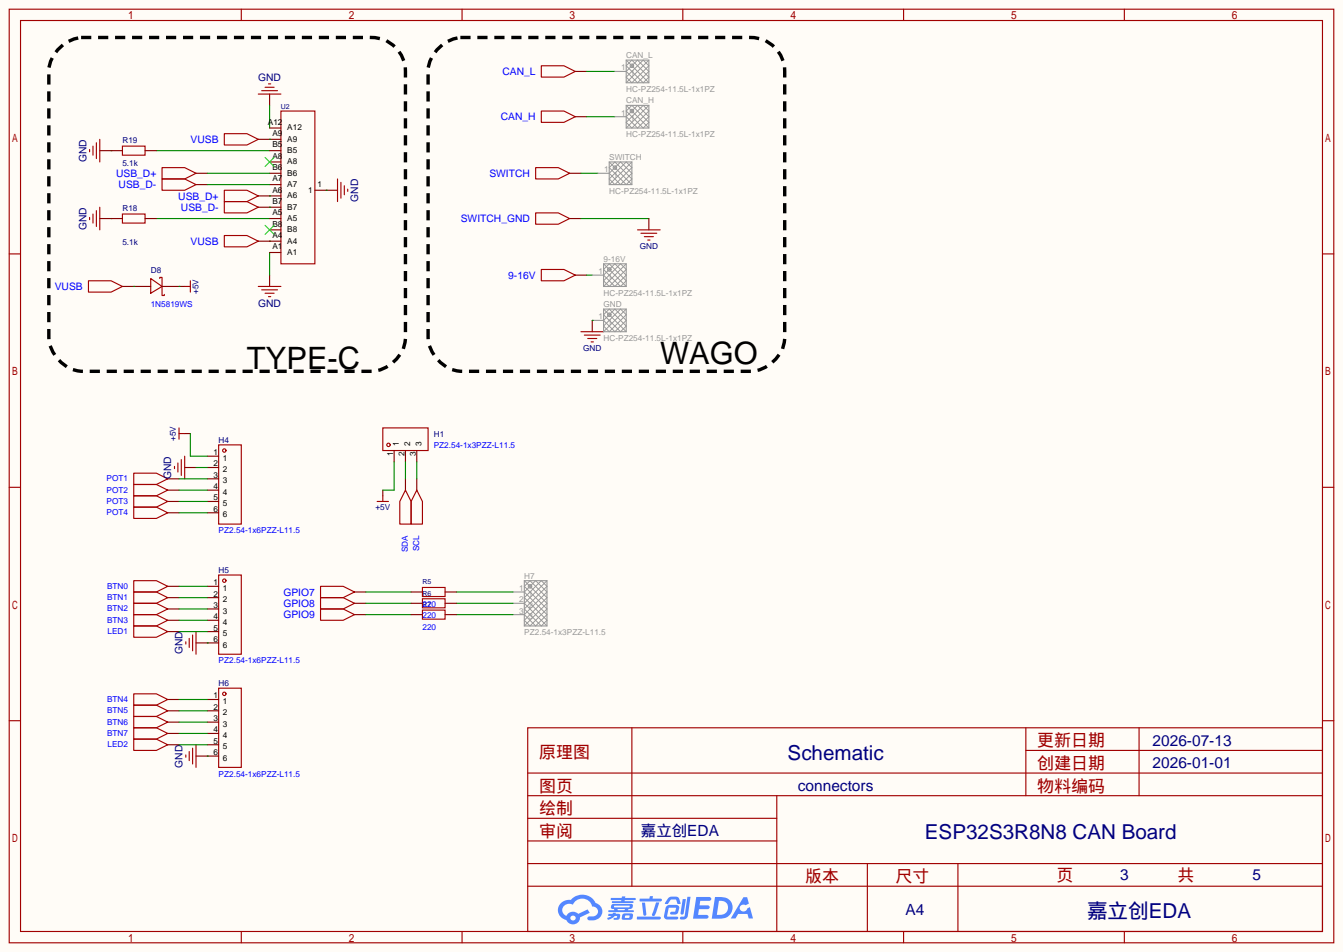
[picture p15: page 5]

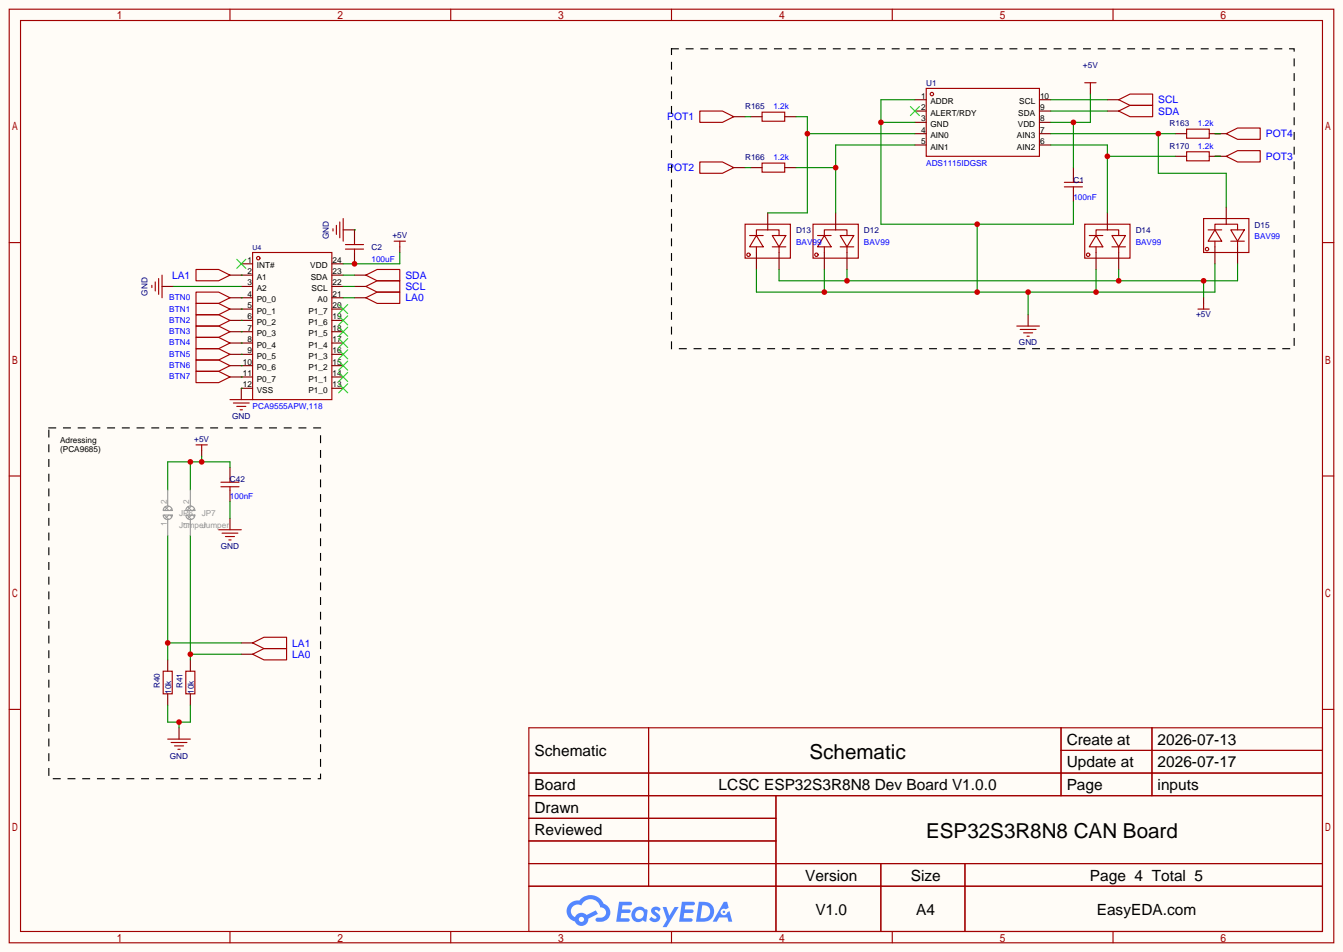
[picture p16: page 6]

Schematic | Schematic | Create at | 2026-07-13

Update at | 2026-07-17

Board | LCSC ESP32S3R8N8 Dev Board V1.0.0 | Page | inputs
Drawn | | ESP32S3R8N8 CAN Board
Reviewed

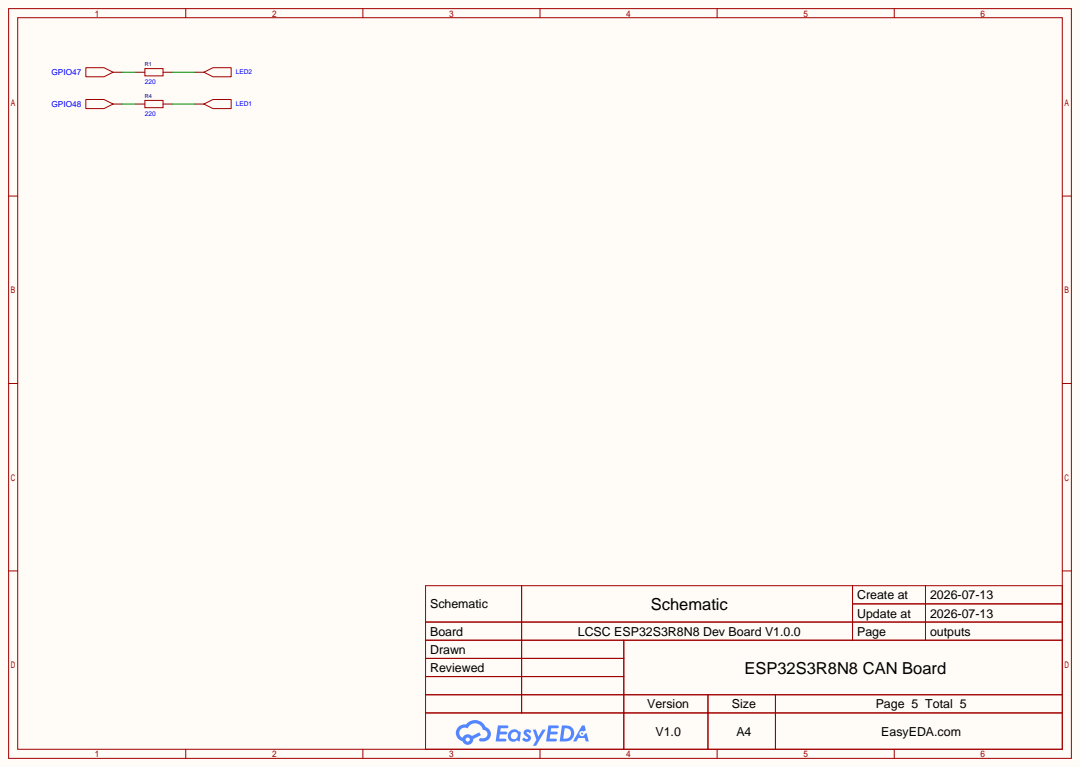
[picture p17: page 7]

Schematic | Schematic | Create at | 2026-07-13

Update at | 2026-07-13

Board | LCSC ESP32S3R8N8 Dev Board V1.0.0 | Page | outputs
Drawn | | ESP32S3R8N8 CAN Board
Reviewed
