gunicsba/AgIsoAuxInputs/(commit log)

2026-09-04 Add real ISOBUS AUX-N joystick firmware (joystick_aux_n)
    Builds on AgIsoStack-plus-plus instead of this repo's proprietary CAN
    protocol, so the joystick can plug into any ISO 11783 network / Virtual
    Terminal and have its inputs assigned through the VT's normal aux-assignment
    screen. Exposes all 4 ADS1115 analog channels and the 16 extender-PCA9555
    buttons as Auxiliary Input Type 2 objects, each with a text designator
    (T1-T4 top row, MU/MD/MR/ML/MC middle, DL+/DL-/DR+/DR- diagonals - mapped by
    physically pressing each button and reading the bit index from serial) so
    they're identifiable in the VT's assignment UI. Object pool is generated
    offline by tools/build_aux_pool.py from a byte layout r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
    [partitions_aux_n_8mb.csv]
2026-09-13 Restructure as standalone AgIsoAuxInputs repo
    Moved the AUX-N joystick firmware out of ESP_CAN_ECU_joystick_collection
    into its own repo, laid out like AgIsoRelayBlock:
    - firmware/: PlatformIO project (envs joystick / joystick_ota, renamed from
    joystick_aux_n*), joystick_aux_n.cpp -> src/main.cpp, pool builder under
    firmware/tools. Dropped the old repo's lib_ignore and the src/CMakeLists
    source-exclusion workaround comments, which no longer apply.
    - hardware/: schematic, Gerbers, BOM, pick-and-place and 3D models for the
    ESP32S3R8N8 CAN board and joystick.
    - README, WTFPL license, .gitignore.
    Verified: both envs build, and the regenerated object pool is
    byte-identical to the commit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
    [BOM_Joystick Front_PCB1_2026-07-20.xlsx, BOM_LCSC ESP32S3R8N8 Dev Board V1.0.0_PCB_2026-07-20.xlsx, PickAndPlace_PCB1_2026_07_20.xlsx, PickAndPlace_PCB_2026_07_20.xlsx, joystick.3mf, joystick.f3d, joystickbutton.3mf, joystickbutton.f3z]
2026-09-13 Mark hardware and binary assets as binary in .gitattributes
    Without this, git's text heuristic treats schematic.pdf as text, so a checkout with core.autocrlf=true would convert its line endings and corrupt it.
2026-09-13 Organize hardware per board and enclosure, add release packaging
    - hardware/boards/{brain,joystick_front}: Gerber, BOM and pick-and-place
    per PCB with stable (undated) file names and a README each.
    - hardware/enclosures/{jh-d400x,joystick_front}: 3D models per housing.
    - One shared hardware/schematic.pdf; dropped the per-page PNG exports.
    - tools/package_release.py + release workflow: pushing a v* tag publishes
    one ZIP per board and per enclosure (board ZIPs include the schematic),
    so nobody has to download PCBs they don't need.
    - Documented the Joystick Front address jumpers (default 0x20 clashes with
    the brain board's PCA9555) and that silkscreen button numbers equal the
    PCA9555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
    [BOM_brain.xlsx, BOM_joystick_front.xlsx, PickAndPlace_brain.xlsx, PickAndPlace_joystick_front.xlsx, jh-d400x_enclosure.3mf, jh-d400x_enclosure.f3d, joystick_front_enclosure.3mf, joystick_front_enclosure.f3z]
2026-09-13 Rename Joystick Front keypad to Handgrip, credit HARDI NOVA inspiration
    Neutral, descriptive name for the 13-button grip keypad so the project
    doesn't borrow HARDI's product naming. The READMEs credit the HARDI NOVA
    sprayer grip as the layout inspiration, say the project isn't affiliated
    with HARDI, and note that the schematic still titles the board
    "Joystick Front".
    [BOM_handgrip.xlsx, PickAndPlace_handgrip.xlsx, handgrip_enclosure.3mf, handgrip_enclosure.f3z]
2026-09-13 Add hardware photos to the READMEs
    Brain board, Handgrip keypad PCB and printed Handgrip housing photos, each
    shown in its own README, plus a photo overview at the top of the main
    README. Brain board connector table now uses the silkscreen names and
    shows the combined UART/I2C header (RX, TX, 3V3, GND, SCL, SDA, 5V).
2026-09-13 v0.2 added FASTLED compatible leds
    [BOM_brain.xlsx, BOM_handgrip.xlsx, PickAndPlace_brain.xlsx, PickAndPlace_handgrip.xlsx]
2026-09-13 Substitute out-of-stock parts on brain and handgrip boards
    Brain: replace NCV68061 ideal diode controller with LM74700-Q1 (U7) and
    add C3. Handgrip: replace SK6805-EC15 LEDs with SK6805D-EC2018.
    Updated Gerbers, BOMs, pick-and-place files and brain PCB PDF.
    [BOM_brain.xlsx, BOM_handgrip.xlsx, PickAndPlace_brain.xlsx, PickAndPlace_handgrip.xlsx]
2026-09-17 Fix AUX-N pool rejection on VT3 and illegal Working Set child
    Designator justification used vertical-middle bits that are reserved
    on VT3 and older, which is what got the pool rejected outright on a
    real VT3 unit. Ship the VT3-safe justification by default and have
    the firmware upgrade it to full centering in a mutable copy of the
    pool once it confirms the connected VT is version 4+, instead of
    permanently giving up vertical centering on newer VTs.
    Also fix the Working Set object listing the Data Mask as a child,
    which ISO 11783-6 doesn't allow there (some VTs tolerate it, making
    this one latent rather than fatal) - point it at the existing TEST
    OutputString instead, which is a legal child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
    [build_aux_pool.py, main.cpp]
2026-10-10 Add LED lights, VT handgrip screen and CAN robustness to the joystick
    LEDs on GPIO7 (Adafruit NeoPixel): red while no VT is connected, green
    for 5 s after it connects, then the operator's settings. A new Lights
    data mask has a mode button (Rainbow/Colour/White), R/G/B and brightness
    inputs (yellow, framed), stored in NVS. Soft keys toggle the lights and
    switch between the main and Lights masks.
    The main mask now draws the handgrip's buttons and LED positions; each
    button is highlighted while pressed. It also shows a title, the repo URL
    and the firmware commit (from tools/git_version.py, sent at runtime so a
    new commit doesn't change the pool). The working set is now selectable
    with a "JOY"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
2026-10-10 Add settings page, multi-page AUX-N mode and LED press feedback
    Settings data mask (SETUP soft key): page mode, per-page LED colours and
    a press-flash toggle, stored in NVS. The page mode picks one of two
    object pools at boot, so switching needs a restart (RESTART button).
    Multi-page mode: T1-T4 select page 1-4 (yellow on the VT, LEDs show the
    page colour). The other buttons get an AUX input per page plus "*" for
    all pages; a press goes to the current page's input when a function is
    assigned to it, otherwise to "*". Assignments are learned by passively
    reassembling the VT's Auxiliary Assignment Type 2 commands (TP to the
    implement). Small squares on each button show the active input.
    The "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
2026-10-13 Add View-T Wi-Fi/CAN bridge and Wi-Fi setup page
    joystick_viewt lets the View-T Android app (Proemion Byte Command
    Protocol over TCP port 30000) act as the VT for the AUX-N, with or
    without anything else on the CAN bus. The ESP32-S3 has one TWAI
    controller, so BridgedTWAIPlugin sits under PacedTWAIPlugin as the only
    path to it: one RX task fans bus frames out to the stack and the
    tablet, stack frames go to the bus and the tablet, and tablet frames go
    to the bus and back into our own stack (TWAI never receives its own
    transmissions). With no node to ACK, stack frames still reach the
    tablet once the controller is error-passive.
    The device ID the app reads is the board's own MAC; license, demo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
2026-10-13 Add /debug page, Wi-Fi OTA target and bridge reconnect fixes
    Boards are mostly reached over Wi-Fi now, so make them diagnosable
    there: a /debug page (plain text) with uptime, reset reason, heap,
    CAN/VT state, AP/station state with the last disconnect reason, bridge
    session details, and a RAM ring of recent log lines (our messages plus
    the CAN stack's Info and above). Wi-Fi events - station disconnect
    reasons, phones joining/leaving the AP - are logged.
    Likely causes of the View-T connection drops, fixed:
    - A reconnecting app was left in the listen backlog while the old,
    half-open socket still looked alive; a new connection now replaces
    the current one, and TCP keepalive drops dead peers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
2026-10-14 Keep bridge sessions alive while the client stalls
    A 3.5 h AgIsoVirtualTerminal session (via the Proemion CANlink plugin)
    ended when the client stopped reading long enough to fill the TCP
    buffers: the bridge closed the socket after a 2 s stalled write, and
    that client never reconnects, so the VT stayed dead.
    ISOBUS recovers from lost frames by itself (VT status and TP timeouts),
    a closed connection doesn't for such a client. So writes no longer
    block or time out: whole frames go through a non-blocking TX buffer,
    frames that don't fit the CAN-to-TCP queue during a stall are dropped
    (also on overflow, which used to close the session too), and after a
    stall of 1 s or more the backlog is discar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
2026-10-14 Rename the View-T bridge to CANlink bridge
    The bridge speaks the Proemion CANlink Byte Command Protocol and serves
    any CANlink client (AgIsoVirtualTerminal with AgIsoStack's CANlink
    plugin as well as the View-T app), so name it after the protocol:
    canlink_bridge.{h,cpp}, ENABLE_CANLINK_BRIDGE, env joystick_canlink,
    mDNS service _canlink._tcp. The hostname is now joystick-auxn, as in
    the plain OTA build.
    View-T stays only where it is load-bearing: the SoftAP SSID the app
    looks for, the comments on the object dictionary entries it uses for
    licensing, and the "viewt-od" NVS namespace that already holds stored
    values.
2026-10-14 Drive the LED strip from a dedicated RMT channel
    The strip blinked now and then. With ESP-IDF 4.4, Adafruit_NeoPixel's
    show() installs the RMT driver anew for every frame (50 fps) with one
    48-bit memory block, so a 9-pixel frame (216 bits) depends on several
    refill interrupts mid-frame. A late refill (CAN/Wi-Fi interrupts, flash
    writes) leaves the RMT without data and the pixels latch garbage.
    Install one RMT channel once with enough memory blocks for the whole
    frame plus end marker: the frame is copied in up front and clocked out
    by hardware with no refill interrupt. Frames are sent only when the
    pixels change (every frame in rainbow mode), plus a refresh every
    second. Adafruit_NeoPixel st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
2026-10-14 Make the mDNS name configurable on the /wifi page
    The board's network name (mDNS and DHCP) can be changed on /wifi and is
    stored in NVS. It applies live: mDNS restarts under the new name and
    re-announces every registered service, which is why services now go
    through wifi_add_mdns_service() (the CANlink bridge's _canlink._tcp
    included) instead of straight to MDNS. The DHCP name follows on the
    next station connect.
    The OTA script no longer fails when the board reboots before its reply
    arrives (seen as a 120 s timeout): it waits for /debug and checks the
    board reports the commit that was just built.
2026-10-15 Attach flashable firmware images to releases
    The release workflow now builds every PlatformIO env and attaches a
    -full.bin (bootloader + partitions + OTA data + app, flashed at 0x0) and a
    -update.bin (for the /update page) per env. A blank board can then be
    flashed from the browser with esptool-js, without installing PlatformIO.
    The README documents both flows.
2026-10-15 Warn that esptool-js defaults to flash address 0x1000
    On the ESP32-S3 the merged image must go to 0x0; at 0x1000 the ROM finds
    a broken bootloader and resets in a loop.
2026-10-17 Keep the newest frame per CAN ID after a tablet stall
    After a stall of 1 s or more the bridge discarded the whole CAN-to-TCP
    backlog, including the joystick's own Working Set Maintenance, so AgIsoVT
    saw a gap of the stall plus up to a maintenance period on each side and
    dropped the working set even after stalls well under its 3 s timeout.
    The backlog is now compacted to the newest frame per CAN ID instead (in
    order), after stalls of 2 s or more and whenever the queue runs nearly full
    during a stall, so a full queue no longer drops the newest frames. Stalls
    log the station RSSI at start and end, and /debug lists the last 5.
    When a tablet connects, the bridge also sends a global Request for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
2026-10-17 Log the VT's hardware features and operator input events
    On an AMATRON 3 the on-screen MODE button did nothing. /debug now shows
    the VT's Get Hardware features (touchscreen, pointing device, ...) and
    every soft key, button, pointing, select, ESC and numeric change event the
    VT sends us, to tell a press that never arrives from one that's ignored.
2026-10-18 Scale the object pool to the connected VT's mask and soft keys
    ISO 11783-6 (4.6.16) leaves scaling to the Working Set. A 480x480 layout
    showed only its top-left on a 200x200 AMATRON 3, a 400x400 Mueller got the
    200 layout at half size, and its 120x80 soft keys showed 60x32 labels in a
    corner.
    The builder now makes two hand-made layouts per page mode, full (480) and
    compact (200, one settings button per row, shortened static texts), padded
    to the same size since the pool size is sent before the VT's mask is
    known. Every coordinate, size, line width and font that depends on the
    mask or soft key designator is recorded with its reference value; soft key
    fields carry a square (60x60) and a wide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
2026-10-18 Release only the joystick_canlink firmware
    It's the fullest build (web pages, Wi-Fi updates, CANlink bridge), and its
    update image also works on boards running joystick_ota, which shares its
    partition table. The other envs remain for local builds.
2026-10-18 Follow ISO 11783-6 Annex J as an auxiliary input unit
    A Mueller BASIC Terminal wouldn't offer the joystick for assignment.
    Checked against ISO 11783-6:2014 Annex J:
    - AgIsoStack answered a Status Enable command for object ID FFFF (all
    inputs, disable only - J.7.11) with "invalid object ID", and a VT may
    then drop the input unit. It also sent every input's status once a
    second although J.7.9 forbids status until the VT enables the input.
    tools/patch_agisostack.py fixes both (plus 200 ms held repeats) in the
    downloaded library before it's compiled; neither is fixed upstream.
    - Buttons now report 1 on the press and 2 while held, repeated every
    200 ms: an implement takes a held inpu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
2026-10-18 Wait for a real reboot after an OTA upload
    The upload check only compared the commit on /debug, so a rebuild with
    the same uncommitted changes passed while the board was still running the
    old firmware after a failed update. It now also requires an uptime shorter
    than the time since the upload started.
2026-11-09 CANlink bridge: one client per port on 30000-30003 (VT + TC share one link)
    Each of the four ports takes one client, so a VT and a TC on the same
    tablet can share the bridge instead of replacing each other's session.
    A new connection still replaces the old one, but only on its own port
    (an app reconnecting after a Wi-Fi drop). Only 30000 is announced over
    mDNS.
    Frames from one client also go to the other clients (CANlink wireless
    4000 MultiTalk, object 0x3008:0x04, default on and persisted); TWAI
    doesn't receive its own transmissions, so they'd never see each other
    otherwise. Writing 0 gives MultiPoint behaviour.
    Per-client queues are created on first use of a port, so a single
    client cost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
2026-11-09 wifi_setup: cast WiFi.channel() for %u (int32_t in newer arduino-esp32)
    The unpinned espressif32 platform now returns int32_t, which fails the
    build with -Werror=format.
    Claude-Session: https://claude.ai/code/session_018b9DEAyo2SmQNe82VHTrWx
